FishyNavi/keyboard/firmware/keyboards/he16/README.md

# HE16

HE16 is a proof-of-concept 16-key Hall-effect keyboard with 8kHz polling rate.

- **Keyboard Maintainer**: [peppapighs](https://github.com/peppapighs)
- **Hardware Support**: [peppapighs/HE16](https://github.com/peppapighs/HE16)
- **Bootloader**: Factory AT32 DFU bootloader. Enter the bootloader through the following methods:
  - Hold **BOOT** button while plugging in the keyboard.
  - Press the `SP_BOOT` binding.
  - Use the web configurator.
