FishyNavi/keyboard/firmware/keyboards/he60/README.md

# HE60

HE60 is a Tsangan layout 60% Hall-effect keyboard.

- **Keyboard Maintainer**: [peppapighs](https://github.com/peppapighs)
- **Hardware Support**: [peppapighs/HE60](https://github.com/peppapighs/HE60)
- **Bootloader**: Factory STM32 DFU bootloader. Enter the bootloader through the following methods:
  - Hold **BOOT** button while plugging in the keyboard.
  - Press the `SP_BOOT` binding.
  - Use the web configurator.
