FishyNavi/keyboard/firmware/keyboards/m256-whe/README.md

# M256-WHE

M256-WHE is a 65% Hall-effect keyboard, built for Mode SixtyFive (2024), Mode Encore, and Mode Envoy.

- **Keyboard Maintainer**: [peppapighs](https://github.com/peppapighs)
- **Hardware Support**: [peppapighs/M256-WHE](https://github.com/peppapighs/M256-WHE)
- **Bootloader**: Factory AT32 DFU bootloader. Enter the bootloader through the following methods:
  - Hold **BOOT** button while plugging in the keyboard.
  - Press the `SP_BOOT` binding.
  - Use the web configurator.
