FishyNavi/keyboard/bom.md

All of the components are avaible on LCSC:
| Description | Quantity | Unit Price ($) | LCSC# | Product Link |
| --- | --- | --- | --- | --- |
| 100nF ±10% 50V Ceramic Capacitor X7R 0805 | 40 | 0.0191 | C49678 | [Link](https://www.lcsc.com/product-detail/C49678.html) |
| 1uF ±10% 50V Ceramic Capacitor X7R 0805 | 30 | 0.0403 | C28323 | [Link](https://www.lcsc.com/product-detail/C28323.html) |
| 4.7uF ±10% 25V Ceramic Capacitor X5R 0805 | 40 | 0.0348 | C1779 | [Link](https://www.lcsc.com/product-detail/C1779.html) |
| USB-C (USB TYPE-C) Receptacle Connector 16 Position Surface Mount | 5 | 0.1729 | C165948 | [Link](https://www.lcsc.com/product-detail/C165948.html) |
| 10kΩ ±1% 125mW 0805 Thick Film Resistor | 100 | 0.0034 | C2907219 | [Link](https://www.lcsc.com/product-detail/C2907219.html) |
| 5.1kΩ ±1% 125mW 0805 Thick Film Resistor | 100 | 0.0056 | C27834 | [Link](https://www.lcsc.com/product-detail/C27834.html) |
| SOT-23-3L Linear, Compass (ICs) | 65 | 0.1332 | C52993621 | [Link](https://www.lcsc.com/product-detail/C52993621.html) |
| Tactile Switch SPST 250gf 1.5mm SMD (SMT) Tab 5.2mm x 5.2mm Surface Mount | 40 | 0.0099 | C29780122 | [Link](https://www.lcsc.com/product-detail/C29780122.html) |
| 3.3V Positive Fixed SOT-223 Voltage Regulators - Linear, Low Drop Out (LDO) Regulators RoHS | 1 | 0.8178 | C500795 | [Link](https://www.lcsc.com/product-detail/C500795.html) |
| ARM Cortex-M4F 32 Bit 170MHz LQFP-48(7x7) Microcontrollers RoHS | 1 | 5.0690 | C529355 | [Link](https://www.lcsc.com/product-detail/C529355.html) |
| IC SWITCH 8:1 350Ω TSSOP-16 | 10 | 0.1317 | C19723805 | [Link](https://www.lcsc.com/product-detail/C19723805.html) |
And well, if you live in Poland, here's all of the stuff with links that is needed to build and assemble the keyboard
| Item | Qty| Price| Link|
| --- | --- | --- | ---- |
| Outemu Brown Magnetic | 1 | $22.00 | https://aliexpress.com/item/1005008788637777.html|
| PCB Manufacturing | 1 | $15.00 | https://jlcpcb.com/|
| 50x25 1.5mm Alluminum sheet | 1 | $7.50  | https://allegro.pl/oferta/blacha-aluminiowa-1-5mm-25x50cm-12704885515|
| ABS filament | 1 | $10.10 | https://allegro.pl/produkt/filament-abs-black-czarny-prof-lab-1-75mm-1000g-drukarka-3d-c3fd2ea6-55dd-499d-8f05-bc29d6a82e01?offerId=18720860387|
| Some m2 screws | 1 | $6.10  | https://allegro.pl/produkt/czarne-srubki-wkrety-do-laptopow-m2-m2-5-m3-500szt-etui-a6017095-a644-4f27-bb14-4f102ffaa804?offerId=14449205518|
| Brass 4mm spacers | 1 | $1.50  | https://allegro.pl/produkt/tulejka-5mm-m2-mosiezna-w-w-10szt-1ca050a1-c399-47c0-9345-0784cf25b5ed?offerId=12594992518|
| Tax & shipping(What i paid) | | $31.00| It's alot |
