FishyNavi/keyboard/bom.csv

Index | LCSC# | MPN | Manufacturer | Package | Customer # | Description | RoHS | Quantity | MOQ | Multiple | Unit Price($) | Extended Price($) | Product Link
1 | C49678 | CC0805KRX7R9BB104 | YAGEO | 0805 |  | 100nF ±10% 50V Ceramic Capacitor X7R 0805 | yes | 40 | 20 | 20 | 0.0191 | 0.76 | https://www.lcsc.com/product-detail/C49678.html
2 | C28323 | CL21B105KBFNNNE | Samsung Electro-Mechanics | 0805 |  | 1uF ±10% 50V Ceramic Capacitor X7R 0805 | yes | 30 | 10 | 10 | 0.0403 | 1.21 | https://www.lcsc.com/product-detail/C28323.html
3 | C1779 | CL21A475KAQNNNE | Samsung Electro-Mechanics | 0805 |  | 4.7uF ±10% 25V Ceramic Capacitor X5R 0805 | yes | 40 | 20 | 20 | 0.0348 | 1.39 | https://www.lcsc.com/product-detail/C1779.html
4 | C165948 | TYPE-C-31-M-12 | Korean Hroparts Elec | SMD |  | USB-C (USB TYPE-C) Receptacle Connector 16 Position Surface Mount | yes | 5 | 5 | 5 | 0.1729 | 0.86 | https://www.lcsc.com/product-detail/C165948.html
5 | C2907219 | FRC0805F1002TS | FOJAN | 0805 |  | 10kΩ ±1% 125mW 0805 Thick Film Resistor | yes | 100 | 100 | 100 | 0.0034 | 0.34 | https://www.lcsc.com/product-detail/C2907219.html
6 | C27834 | 0805W8F5101T5E | UNI-ROYAL | 0805 |  | 5.1kΩ ±1% 125mW 0805 Thick Film Resistor | yes | 100 | 100 | 100 | 0.0056 | 0.56 | https://www.lcsc.com/product-detail/C27834.html
7 | C52993621 | SC4702SO-N-TR | Semiment | SOT-23-3L |  | SOT-23-3L Linear, Compass (ICs) | yes | 65 | 5 | 5 | 0.1332 | 8.66 | https://www.lcsc.com/product-detail/C52993621.html
8 | C29780122 | GT-TZ084B-H015-L1 | G-Switch | SMD-4P,5.2x5.2mm |  | Tactile Switch SPST 250gf 1.5mm SMD (SMT) Tab 5.2mm x 5.2mm Surface Mount | yes | 40 | 40 | 40 | 0.0099 | 0.40 | https://www.lcsc.com/product-detail/C29780122.html
9 | C500795 | AP7361C-33E-13 | DIODES | SOT-223 |  | 3.3V Positive Fixed SOT-223 Voltage Regulators - Linear, Low Drop Out (LDO) Regulators RoHS | yes | 1 | 1 | 1 | 0.8178 | 0.82 | https://www.lcsc.com/product-detail/C500795.html
10 | C529355 | STM32G431CBT6 | ST | LQFP-48(7x7) |  | ARM Cortex-M4F 32 Bit 170MHz LQFP-48(7x7) Microcontrollers RoHS | yes | 1 | 1 | 1 | 5.0690 | 5.07 | https://www.lcsc.com/product-detail/C529355.html
11 | C19723805 | 74HC4051PWRG | HANSCHIP semiconductor | TSSOP-16 |  | IC SWITCH 8:1 350Ω TSSOP-16 | yes | 10 | 5 | 5 | 0.1317 | 1.32 | https://www.lcsc.com/product-detail/C19723805.html
