FishyNavi/keyboard/pcb/production/HACKYBOARD_PROD_bom.csv

Designator | Footprint | Quantity | Value | LCSC Part #
C1, C11, C12, C13, C14, C15, C16, C17, C18, C2, C3, C4, C5, C8 | 0805 | 14 | 0.1uF
C10, C7, C9 | 0805 | 3 | 4.7uF
C6 | 0805 | 1 | 1uF
J1 | SolderWire-1sqmm_1x05_P5.4mm_D1.4mm_OD2.7mm | 1 | Conn_01x05_Socket
J2 | USB_C_Receptacle_G-Switch_GT-USB-7010ASV | 1 | Korean Hroparts Elec TYPE-C-31-M-12
R1 | 0805 | 1 | 10K
R2, R3 | 0805 | 2 | 5K1
REF1, REF10, REF11, REF12, REF13, REF16, REF17, REF18, REF19, REF2, REF20, REF21, REF22, REF23, REF24, REF25, REF26, REF27, REF3, REF30, REF31, REF32, REF33, REF34, REF35, REF36, REF37, REF38, REF39, REF4, REF40, REF43, REF44, REF45, REF46, REF47, REF48, REF49, REF5, REF50, REF51, REF52, REF6, REF7, REF8, REF9 | SW_Cherry_MX_PCB_1.00u_no_pins | 46 | SW_Cherry_MX_PCB_1.00u_no_pins
REF14 | SW_Cherry_MX_PCB_2.00u_no_pins | 1 | SW_Cherry_MX_PCB_2.00u_no_pins
REF15, REF28 | SW_Cherry_MX_PCB_1.50u_no_pins | 2 | SW_Cherry_MX_PCB_1.50u_no_pins
REF29 | SW_Cherry_MX_PCB_1.75u_no_pins | 1 | SW_Cherry_MX_PCB_1.75u_no_pins
REF41, REF42 | SW_Cherry_MX_PCB_2.25u_no_pins | 2 | SW_Cherry_MX_PCB_2.25u_no_pins
REF53 | SW_Cherry_MX_PCB_2.75u_no_pins | 1 | SW_Cherry_MX_PCB_2.75u_no_pins
REF54, REF55, REF56, REF58, REF59, REF60, REF61 | SW_Cherry_MX_PCB_1.25u_no_pins | 7 | SW_Cherry_MX_PCB_1.25u_no_pins
REF57 | SW_Cherry_MX_PCB_6.25u_no_pins | 1 | SW_Cherry_MX_PCB_6.25u_no_pins
S1, S10, S11, S12, S13, S14, S15, S16, S17, S18, S19, S2, S20, S21, S22, S23, S24, S25, S26, S27, S28, S29, S3, S30, S31, S32, S33, S34, S35, S36, S37, S38, S39, S4, S40, S41, S42, S43, S44, S45, S46, S47, S48, S49, S5, S50, S51, S52, S53, S54, S55, S56, S57, S58, S59, S6, S60, S61, S7, S8, S9 | SOT-23-3_HE_SENSOR | 61 | SC4702SO
SW1, SW2 | SW_SPST_TL3342 | 2 | GT-TZ084B-H015-L1
U1 | SOT-223-3_TabPin2 | 1 | AP7361C-33E
U10, U3, U4, U5, U6, U7, U8, U9 | TSSOP-16_4.4x5mm_P0.65mm | 8 | 74HC4051
U2 | LQFP-48_7x7mm_P0.5mm | 1 | STM32G431CBT6
