FishyNavi/keyboard/case/CaseBottom.step

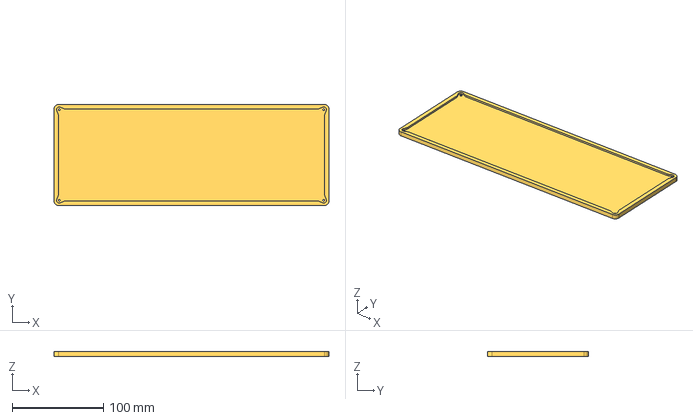
[picture p5: CAD file, 2026-11-02]
case/CaseBottom.step
301.0 x 110.6 x 5.00 mm
