FishyNavi/keyboard/case/SwitchPlate.step

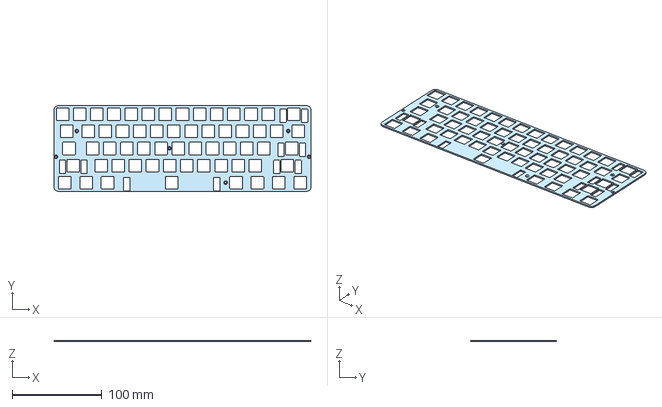
[picture p6: CAD file, 2026-11-02]
case/SwitchPlate.step
285.8 x 95.2 x 1.50 mm
