FishyNavi/keyboard/case/SandwichBottom.step

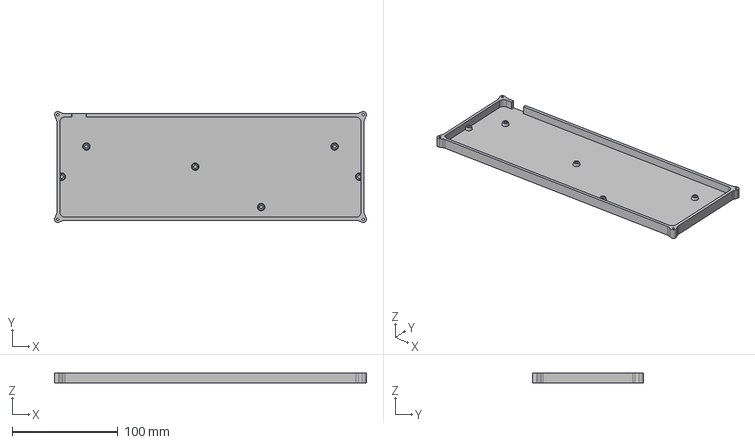
[picture p7: CAD file, 2026-11-02]
case/SandwichBottom.step
295.4 x 105.1 x 9.80 mm
