FishyNavi/keyboard/case/CaseTop.step

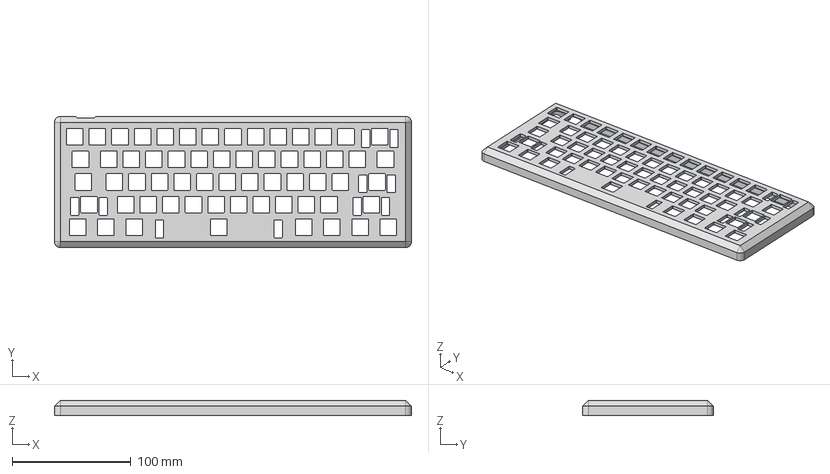
[picture p8: CAD file, 2026-11-02]
case/CaseTop.step
301.0 x 110.6 x 13.0 mm
