FishyNavi/keyboard/(list of files, cad)

Other CAD files:
case/CaseBottom.stl
case/CaseTop.stl
case/SandwichBottom.stl
