FishyNavi/keyboard/pcb/keyboard.kicad_pcb

## KiCad design pcb/keyboard.kicad_pcb (2026-11-02)

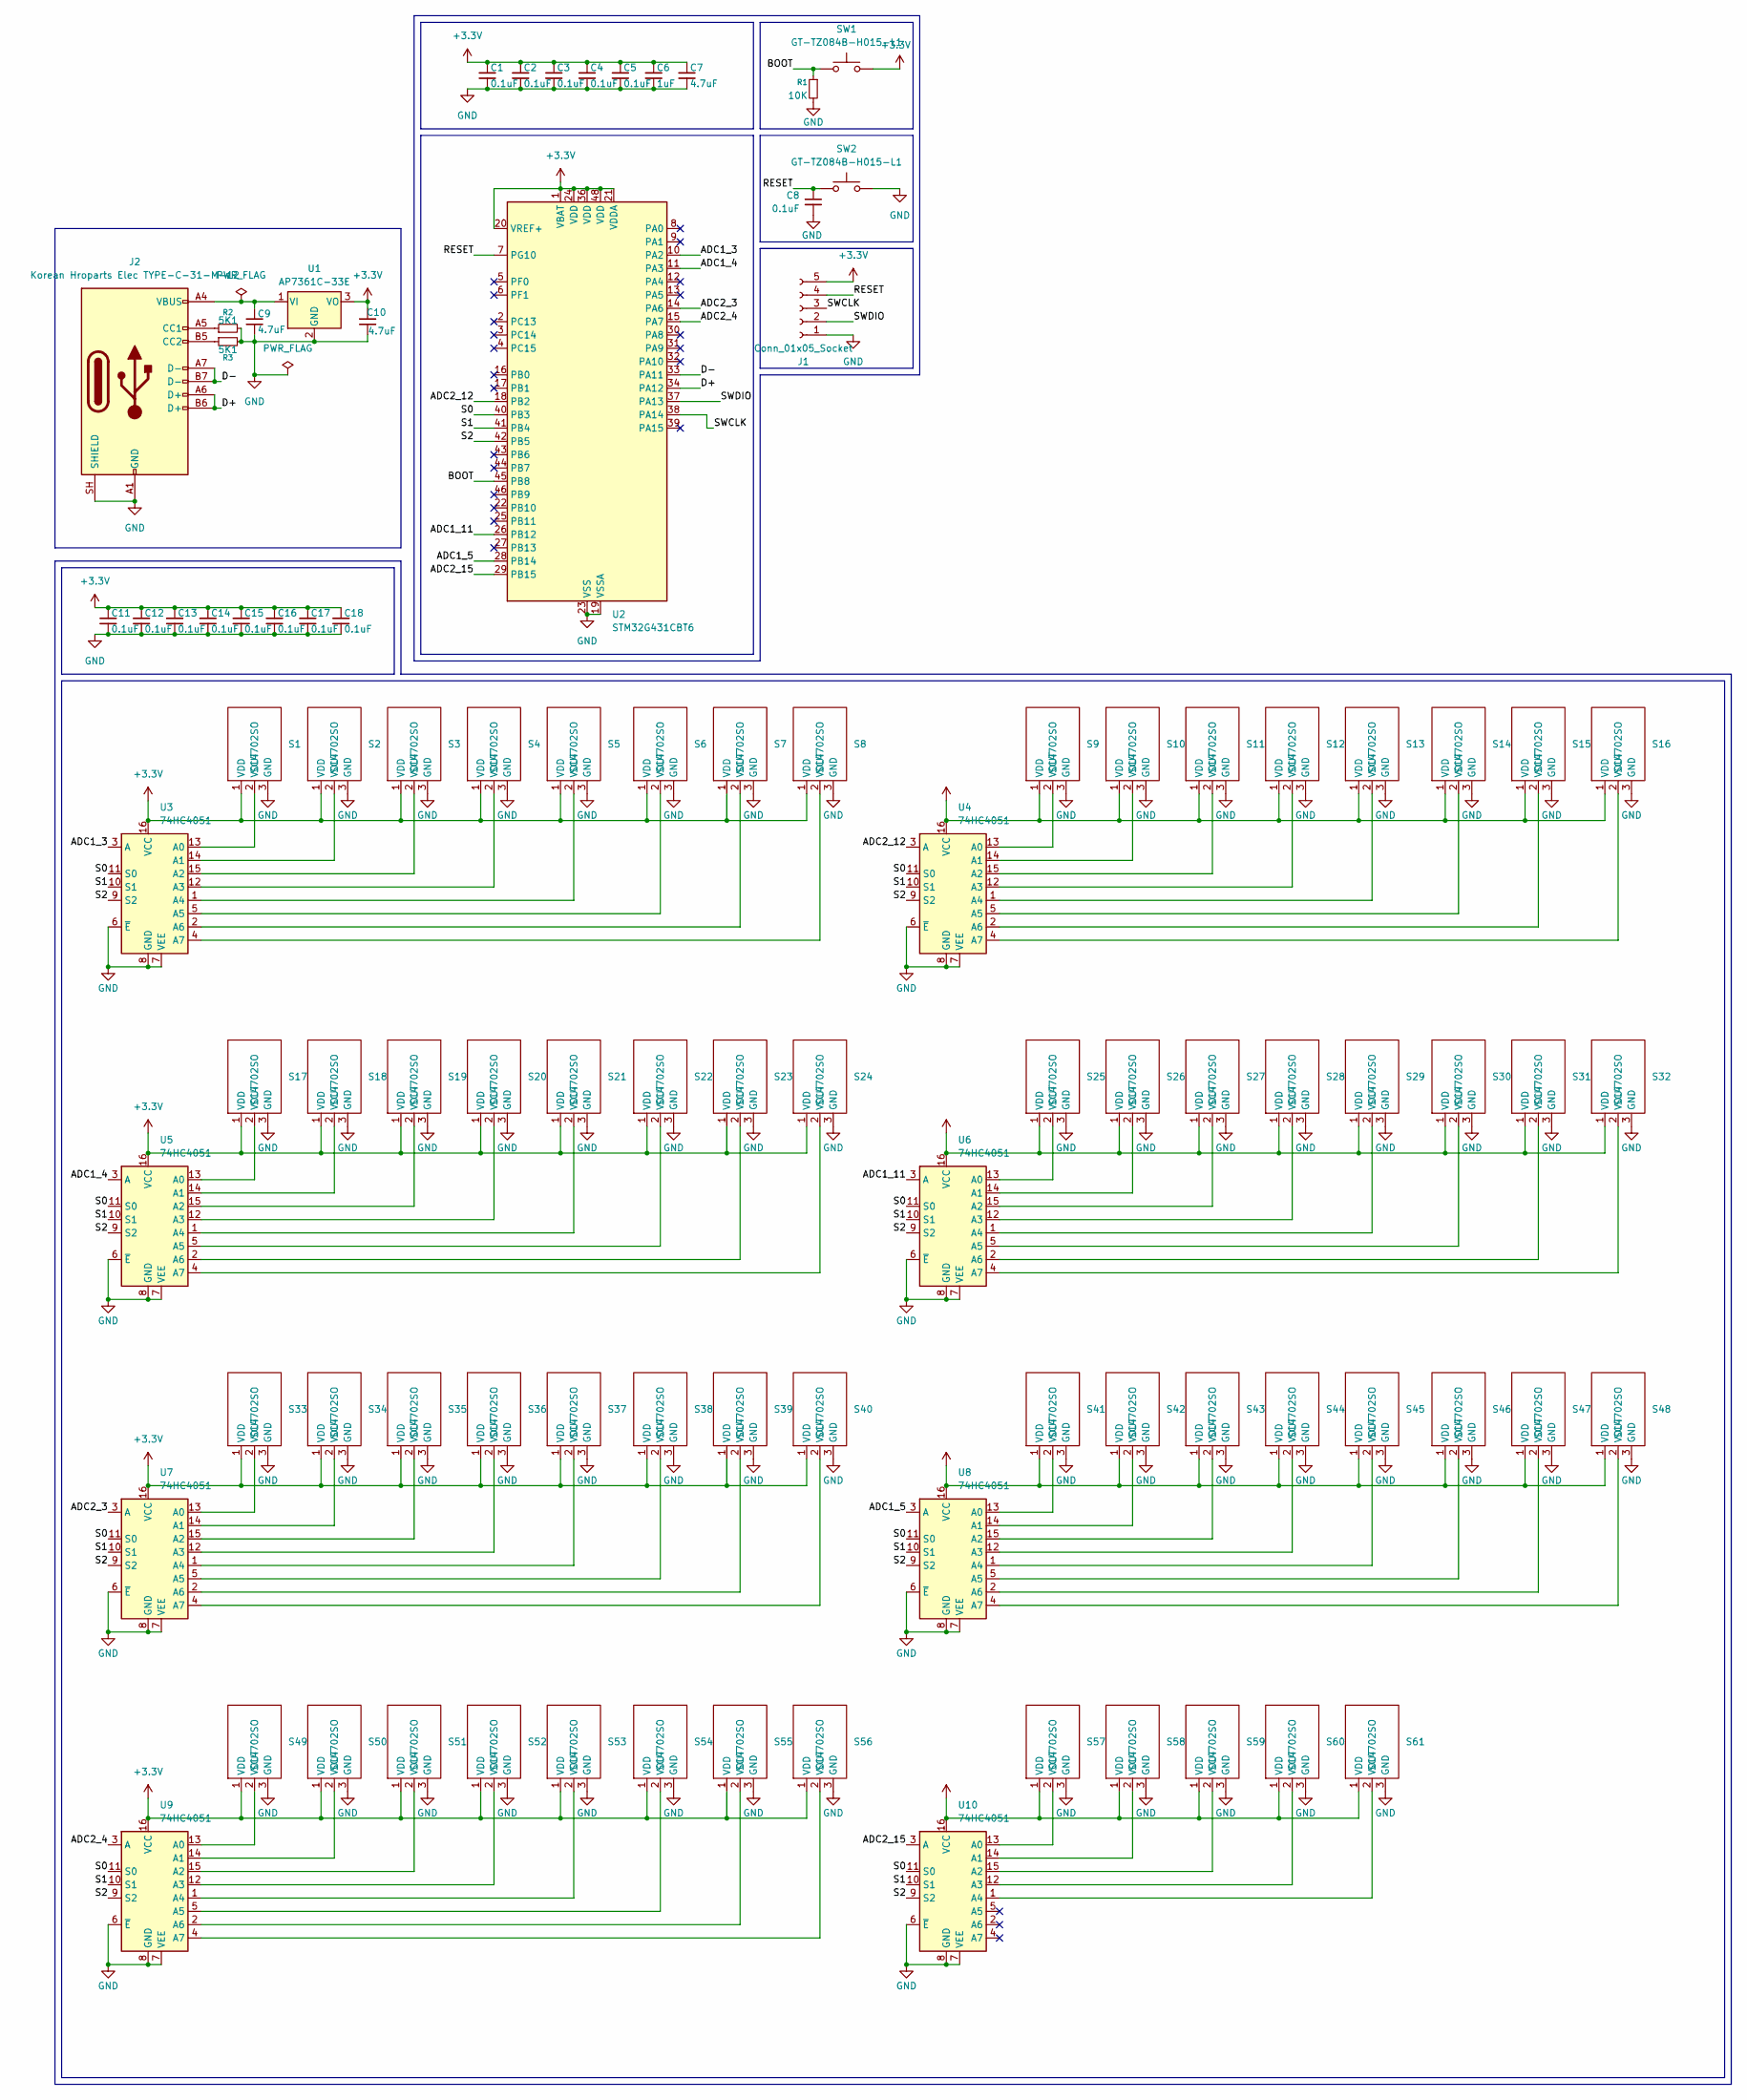
[picture p9: schematic keyboard.kicad_sch]

Parts:
C1, C2, C3, C4, C5, C8, C11, C12, C13, C14, C15, C16, C17, C18: 0.1uF; C_0805_2012Metric
C6: 1uF; C_0805_2012Metric
C7, C9, C10: 4.7uF; C_0805_2012Metric
J1: Conn_01x05_Socket; SolderWire-1sqmm_1x05_P5.4mm_D1.4mm_OD2.7mm
J2: Korean Hroparts Elec TYPE-C-31-M-12; USB_C_Receptacle_G-Switch_GT-USB-7010ASV
R1: 10K; R_0805_2012Metric
R2, R3: 5K1; R_0805_2012Metric
S1, S2, S3, S4, S5, S6, S7, S8, S9, S10, S11, S12, S13, S14, S15, S16, S17, S18, S19, S20, S21, S22, S23, S24, S25, S26, S27, S28, S29, S30, S31, S32, S33, S34, S35, S36, S37, S38, S39, S40, S41, S42, S43, S44, S45, S46, S47, S48, S49, S50, S51, S52, S53, S54, S55, S56, S57, S58, S59, S60, S61: SC4702SO; SOT-23-3_HE_SENSOR
SW1, SW2: GT-TZ084B-H015-L1; SMD-4P,5.2x5.2mm
U1: AP7361C-33E; SOT-223-3_TabPin2
U2: STM32G431CBT6; LQFP-48_7x7mm_P0.5mm
U3, U4, U5, U6, U7, U8, U9, U10: 74HC4051; TSSOP-16_4.4x5mm_P0.65mm

Connections:
+3.3V: C1.1, C2.1, C3.1, C4.1, C5.1, C6.1, C7.1, C10.1, C11.1, C12.1, C13.1, C14.1, C15.1, C16.1, C17.1, C18.1, J1.5, S1.1 (VDD), S2.1 (VDD), S3.1 (VDD), S4.1 (VDD), S5.1 (VDD), S6.1 (VDD), S7.1 (VDD), S8.1 (VDD), S9.1 (VDD), S10.1 (VDD), S11.1 (VDD), S12.1 (VDD), S13.1 (VDD), S14.1 (VDD), S15.1 (VDD), S16.1 (VDD), S17.1 (VDD), S18.1 (VDD), S19.1 (VDD), S20.1 (VDD), S21.1 (VDD), S22.1 (VDD), S23.1 (VDD), S24.1 (VDD), S25.1 (VDD), S26.1 (VDD), S27.1 (VDD), S28.1 (VDD), S29.1 (VDD), S30.1 (VDD), S31.1 (VDD), S32.1 (VDD), S33.1 (VDD), S34.1 (VDD), S35.1 (VDD), S36.1 (VDD), S37.1 (VDD), S38.1 (VDD), S39.1 (VDD), S40.1 (VDD), S41.1 (VDD), S42.1 (VDD), S43.1 (VDD), S44.1 (VDD), S45.1 (VDD), S46.1 (VDD), S47.1 (VDD), S48.1 (VDD), S49.1 (VDD), S50.1 (VDD), S51.1 (VDD), S52.1 (VDD), S53.1 (VDD), S54.1 (VDD), S55.1 (VDD), S56.1 (VDD), S57.1 (VDD), S58.1 (VDD), S59.1 (VDD), S60.1 (VDD), S61.1 (VDD), SW1.1, U1.3 (VO), U2.1 (VBAT), U2.20 (VREF+), U2.21 (VDDA), U2.24 (VDD), U2.36 (VDD), U2.48 (VDD), U3.16 (VCC), U4.16 (VCC), U5.16 (VCC), U6.16 (VCC), U7.16 (VCC), U8.16 (VCC), U9.16 (VCC), U10.16 (VCC)
/ADC1_3: U2.10 (PA2), U3.3 (A)
/ADC1_4: U2.11 (PA3), U5.3 (A)
/ADC1_5: U2.28 (PB14), U8.3 (A)
/ADC1_11: U2.26 (PB12), U6.3 (A)
/ADC2_3: U2.14 (PA6), U7.3 (A)
/ADC2_4: U2.15 (PA7), U9.3 (A)
/ADC2_12: U2.18 (PB2), U4.3 (A)
/ADC2_15: U2.29 (PB15), U10.3 (A)
/BOOT: R1.1, SW1.2, U2.45 (PB8)
/D+: J2.A6 (D+), J2.B6 (D+), U2.34 (PA12)
/D-: J2.A7 (D-), J2.B7 (D-), U2.33 (PA11)
/RESET: C8.1, J1.4, SW2.2, U2.7 (PG10)
/S0: U2.40 (PB3), U3.11 (S0), U4.11 (S0), U5.11 (S0), U6.11 (S0), U7.11 (S0), U8.11 (S0), U9.11 (S0), U10.11 (S0)
/S1: U2.41 (PB4), U3.10 (S1), U4.10 (S1), U5.10 (S1), U6.10 (S1), U7.10 (S1), U8.10 (S1), U9.10 (S1), U10.10 (S1)
/S2: U2.42 (PB5), U3.9 (S2), U4.9 (S2), U5.9 (S2), U6.9 (S2), U7.9 (S2), U8.9 (S2), U9.9 (S2), U10.9 (S2)
/SWCLK: J1.3, U2.38 (PA14)
/SWDIO: J1.2, U2.37 (PA13)
GND: C1.2, C2.2, C3.2, C4.2, C5.2, C6.2, C7.2, C8.2, C9.2, C10.2, C11.2, C12.2, C13.2, C14.2, C15.2, C16.2, C17.2, C18.2, J1.1, J2.A1 (GND), J2.A12 (GND), J2.B1 (GND), J2.B12 (GND), J2.SH (SHIELD), R1.2, R2.2, R3.2, S1.3 (GND), S2.3 (GND), S3.3 (GND), S4.3 (GND), S5.3 (GND), S6.3 (GND), S7.3 (GND), S8.3 (GND), S9.3 (GND), S10.3 (GND), S11.3 (GND), S12.3 (GND), S13.3 (GND), S14.3 (GND), S15.3 (GND), S16.3 (GND), S17.3 (GND), S18.3 (GND), S19.3 (GND), S20.3 (GND), S21.3 (GND), S22.3 (GND), S23.3 (GND), S24.3 (GND), S25.3 (GND), S26.3 (GND), S27.3 (GND), S28.3 (GND), S29.3 (GND), S30.3 (GND), S31.3 (GND), S32.3 (GND), S33.3 (GND), S34.3 (GND), S35.3 (GND), S36.3 (GND), S37.3 (GND), S38.3 (GND), S39.3 (GND), S40.3 (GND), S41.3 (GND), S42.3 (GND), S43.3 (GND), S44.3 (GND), S45.3 (GND), S46.3 (GND), S47.3 (GND), S48.3 (GND), S49.3 (GND), S50.3 (GND), S51.3 (GND), S52.3 (GND), S53.3 (GND), S54.3 (GND), S55.3 (GND), S56.3 (GND), S57.3 (GND), S58.3 (GND), S59.3 (GND), S60.3 (GND), S61.3 (GND), SW2.1, U1.2 (GND), U2.19 (VSSA), U2.23 (VSS), U2.35 (VSS), U2.47 (VSS), U3.6 (~E), U3.7 (VEE), U3.8 (GND), U4.6 (~E), U4.7 (VEE), U4.8 (GND), U5.6 (~E), U5.7 (VEE), U5.8 (GND), U6.6 (~E), U6.7 (VEE), U6.8 (GND), U7.6 (~E), U7.7 (VEE), U7.8 (GND), U8.6 (~E), U8.7 (VEE), U8.8 (GND), U9.6 (~E), U9.7 (VEE), U9.8 (GND), U10.6 (~E), U10.7 (VEE), U10.8 (GND)
unnamed: J2.A5 (CC1), R2.1
unnamed: J2.B5 (CC2), R3.1
unnamed: S1.2 (VOUT), U3.13 (A0)
unnamed: S2.2 (VOUT), U3.14 (A1)
unnamed: S3.2 (VOUT), U3.15 (A2)
unnamed: S4.2 (VOUT), U3.12 (A3)
unnamed: S5.2 (VOUT), U3.1 (A4)
unnamed: S6.2 (VOUT), U3.5 (A5)
unnamed: S7.2 (VOUT), U3.2 (A6)
unnamed: S8.2 (VOUT), U3.4 (A7)
unnamed: S9.2 (VOUT), U4.13 (A0)
unnamed: S10.2 (VOUT), U4.14 (A1)
unnamed: S11.2 (VOUT), U4.15 (A2)
unnamed: S12.2 (VOUT), U4.12 (A3)
unnamed: S13.2 (VOUT), U4.1 (A4)
unnamed: S14.2 (VOUT), U4.5 (A5)
unnamed: S15.2 (VOUT), U4.2 (A6)
unnamed: S16.2 (VOUT), U4.4 (A7)
unnamed: S17.2 (VOUT), U5.13 (A0)
unnamed: S18.2 (VOUT), U5.14 (A1)
unnamed: S19.2 (VOUT), U5.15 (A2)
unnamed: S20.2 (VOUT), U5.12 (A3)
unnamed: S21.2 (VOUT), U5.1 (A4)
unnamed: S22.2 (VOUT), U5.5 (A5)
unnamed: S23.2 (VOUT), U5.2 (A6)
unnamed: S24.2 (VOUT), U5.4 (A7)
unnamed: S25.2 (VOUT), U6.13 (A0)
unnamed: S26.2 (VOUT), U6.14 (A1)
unnamed: S27.2 (VOUT), U6.15 (A2)
unnamed: S28.2 (VOUT), U6.12 (A3)
unnamed: S29.2 (VOUT), U6.1 (A4)
unnamed: S30.2 (VOUT), U6.5 (A5)
unnamed: S31.2 (VOUT), U6.2 (A6)
unnamed: S32.2 (VOUT), U6.4 (A7)
unnamed: S33.2 (VOUT), U7.13 (A0)
unnamed: S34.2 (VOUT), U7.14 (A1)
unnamed: S35.2 (VOUT), U7.15 (A2)
unnamed: S36.2 (VOUT), U7.12 (A3)
unnamed: S37.2 (VOUT), U7.1 (A4)
unnamed: S38.2 (VOUT), U7.5 (A5)
unnamed: S39.2 (VOUT), U7.2 (A6)
unnamed: S40.2 (VOUT), U7.4 (A7)
unnamed: S41.2 (VOUT), U8.13 (A0)
unnamed: S42.2 (VOUT), U8.14 (A1)
unnamed: S43.2 (VOUT), U8.15 (A2)
unnamed: S44.2 (VOUT), U8.12 (A3)
unnamed: S45.2 (VOUT), U8.1 (A4)
unnamed: S46.2 (VOUT), U8.5 (A5)
unnamed: S47.2 (VOUT), U8.2 (A6)
unnamed: S48.2 (VOUT), U8.4 (A7)
unnamed: S49.2 (VOUT), U9.13 (A0)
unnamed: S50.2 (VOUT), U9.14 (A1)
unnamed: S51.2 (VOUT), U9.15 (A2)
unnamed: S52.2 (VOUT), U9.12 (A3)
unnamed: S53.2 (VOUT), U9.1 (A4)
unnamed: S54.2 (VOUT), U9.5 (A5)
unnamed: S55.2 (VOUT), U9.2 (A6)
unnamed: S56.2 (VOUT), U9.4 (A7)
unnamed: S57.2 (VOUT), U10.13 (A0)
unnamed: S58.2 (VOUT), U10.14 (A1)
unnamed: S59.2 (VOUT), U10.15 (A2)
unnamed: S60.2 (VOUT), U10.12 (A3)
unnamed: S61.2 (VOUT), U10.1 (A4)
unnamed: C9.1, J2.A4 (VBUS), J2.A9 (VBUS), J2.B4 (VBUS), J2.B9 (VBUS), U1.1 (VI)

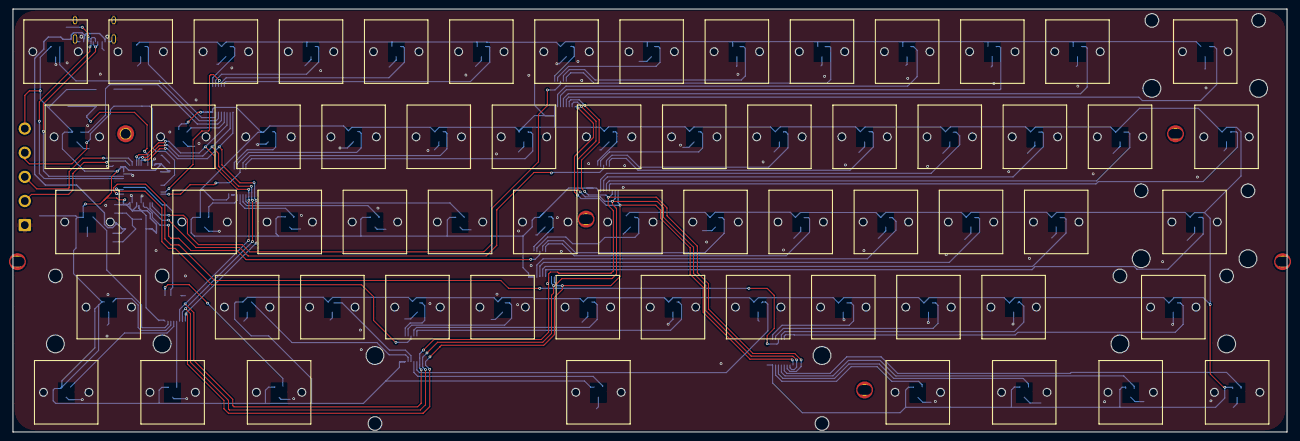
[picture p10: board keyboard.kicad_pcb from above]

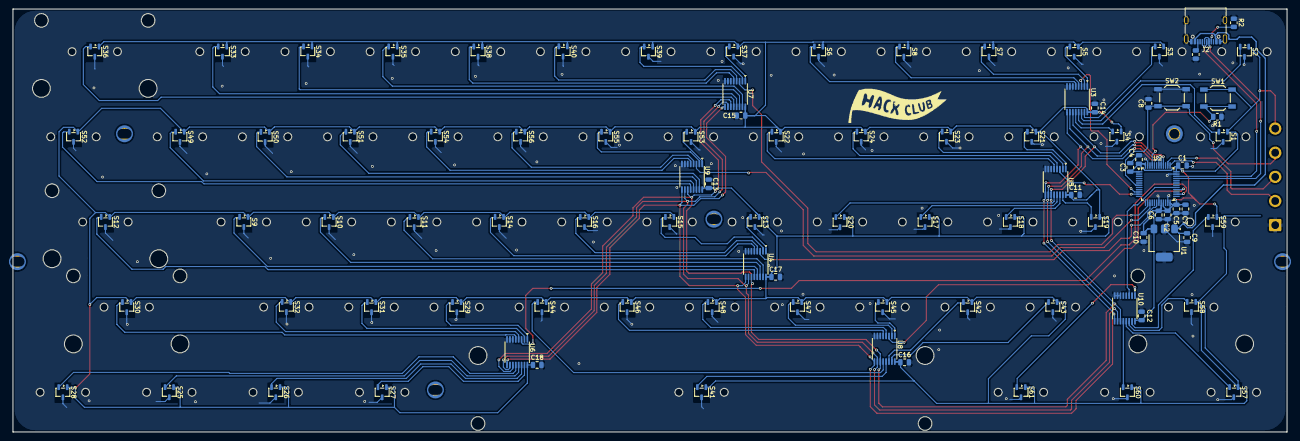
[picture p11: board keyboard.kicad_pcb from below]

Board: 2 copper layers, 285.0 x 94.6 mm, 157 parts (96 on the bottom side), 83 nets.

Other parts of the board:
REF1, REF2, REF3, REF4, REF5, REF6, REF7, REF8, REF9, REF10, REF11, REF12, REF13, REF16, REF17, REF18, REF19, REF20, REF21, REF22, REF23, REF24, REF25, REF26, REF27, REF30, REF31, REF32, REF33, REF34, REF35, REF36, REF37, REF38, REF39, REF40, REF43, REF44, REF45, REF46, REF47, REF48, REF49, REF50, REF51, REF52: SW_Cherry_MX_PCB_1.00u_no_pins
REF14: SW_Cherry_MX_PCB_2.00u_no_pins
REF15, REF28: SW_Cherry_MX_PCB_1.50u_no_pins
REF29: SW_Cherry_MX_PCB_1.75u_no_pins
REF41, REF42: SW_Cherry_MX_PCB_2.25u_no_pins
REF53: SW_Cherry_MX_PCB_2.75u_no_pins
REF54, REF55, REF56, REF58, REF59, REF60, REF61: SW_Cherry_MX_PCB_1.25u_no_pins
REF57: SW_Cherry_MX_PCB_6.25u_no_pins
