FishyNavi/keyboard/(commit log)

2026-10-10 initial commit. fisnished schematic
    [bom.csv, keyboard.kicad_sch]
2026-10-11 Finalize the PCB, change folder structure and add firmware(that doesn't work yet)
    [keyboard.kicad_pcb, keyboard.kicad_sch]
2026-10-11 remove old files
    [bom.csv, keyboard.kicad_sch]
2026-10-11 Add BOM
    [bom.csv]
2026-10-11 Add production files
    [TITLE_PROD_bom.csv, TITLE_PROD_designators.csv, TITLE_PROD_positions.csv]
2026-10-18 img
    Added an image and additional details about the PCB design.
2026-11-02 Small changes
    [TITLE_PROD_bom.csv, TITLE_PROD_designators.csv, TITLE_PROD_positions.csv, bom.csv, keyboard.kicad_pcb]
2026-11-02 Add prod files and make some finishing touches
    [CaseBottom.step, CaseBottom.stl, CaseTop.step, CaseTop.stl, HACKYBOARD_PROD_bom.csv, HACKYBOARD_PROD_designators.csv, HACKYBOARD_PROD_positions.csv, SandwichBottom.step]
